AlecVanVlerken/BeanBot/src/beanbot/Config.h

#ifndef BEANBOT_CONFIG_H
#define BEANBOT_CONFIG_H

#include "Types.h"

namespace Config {

namespace Communication {
constexpr bool useWifi = true;
constexpr unsigned long baud = 115200;
constexpr unsigned long usbBaud = 9600;
constexpr int shieldPin = 25;
constexpr char commandStart[] = "CMDS/";
constexpr char commandEnd[] = "/CMDEND/";
constexpr char setupStart[] = "SETUPB/";
constexpr char setupEnd[] = "/SETUPE/";
}

// The startup defaults and the local/demo request were different in the sketch.
constexpr beanbot::Order initialOrder = {50, 50, 100};
constexpr beanbot::Order demoOrder = {100, 150, 200};
constexpr int reservoirCount = 3;

namespace Servo {
constexpr int carriageConnector = 12;
constexpr int gateConnector = 11;
constexpr int probeConnector = 9;
constexpr int lastChannel = 15; // PCA9685 channel = 15 - shield connector.
constexpr int frequencyHz = 50;
constexpr unsigned long oscillatorHz = 27000000;
constexpr int pulseMin = 80;
constexpr int pulseMax = 409;
constexpr int minimumAngle = 0;
constexpr int standardRange = 180;
constexpr int carriageForward = 0;
constexpr int carriageBack = 180;
constexpr int gateClosed = 145;
constexpr int gateOpen = 45; // Preserve the implementation, not the old "65" comment.
constexpr int probeRange = 270;
constexpr int probeTop = 270;
constexpr int firstProbeStep = 1;
constexpr int lastProbeStep = 120;
constexpr int probeStep = 1;
constexpr unsigned long travelDelayMs = 10000;
// Owner recalls 2.5 as deliberate hardware tuning; retain the original call.
// Its unit and relationship to modeled scan time remain unconfirmed.
constexpr double probeDelayUs = 2.5;
}

namespace Scale {
constexpr int dataPin = 3;
constexpr int clockPin = 2;
constexpr long calibrationFactor = -7050.0;
}

namespace ColorSensor {
constexpr int s0 = 45;
constexpr int s1 = 4;
constexpr int s2 = 53;
constexpr int s3 = 46;
constexpr int outputPin = 28;
constexpr int enablePin = 52;
constexpr unsigned long readingDelayMs = 100;

// Original active classifier: white first, then black, otherwise red.
constexpr int redMaxWhite = 170;
constexpr int greenMinBlack = 220;
}

namespace Conveyor {
constexpr int enablePin = 9;
constexpr int reversePin = 8;
constexpr unsigned long reverseDelayMs = 10000;
}

namespace Frame {
constexpr int stepPin = 12;
constexpr int directionPin = 13;
constexpr int enablePin = 11;
constexpr int smallSteps = 8;
constexpr int largeSteps = 17;
constexpr unsigned long pulseDelayMs = 100;
constexpr unsigned long settleDelayMs = 5000;
}

namespace DistanceSensor {
constexpr int triggerPin = 44;
constexpr int echoPin = 48;
constexpr unsigned int triggerLowUs = 2;
constexpr unsigned int triggerHighUs = 10;
constexpr long microsecondsPerCentimeter = 29;
}

namespace Inventory {
// Preserve the stated values without integer truncation.
constexpr double maximumHeight = 4.72;
constexpr double base = 18.29;
constexpr double angle = 17; // Degrees; converted at the calculation boundary.
constexpr double length = 12.98;
constexpr double rpm = 71.43;
constexpr double initialHeight = 10;
constexpr double radius = 2.4;
constexpr double whiteRedBeanWeight = 1.0 / 3.0;
constexpr double blackBeanWeight = 1.0 / 6.0;
constexpr double whiteRedBeanVolume = 0.75;
constexpr double blackBeanVolume = 0.50;
constexpr double timeIncrement = 2.5;
constexpr double pi = 3.1415;
}

namespace Display {
constexpr int rs = 21; // Owner says to retain the tested pin configuration.
constexpr int enablePin = 14;
constexpr int d4 = 19;
constexpr int d5 = 7;
constexpr int d6 = 6;
constexpr int d7 = 18;
constexpr int columns = 16;
constexpr int rows = 2;
constexpr int redPosition = 2;
constexpr int whitePosition = 3;
constexpr int blackPosition = 1;
}

constexpr unsigned long unloadDelayMs = 10000;

} // namespace Config

#endif
