AlecVanVlerken/BeanBot/src/beanbot/Types.h

#ifndef BEANBOT_TYPES_H
#define BEANBOT_TYPES_H

namespace beanbot {

enum class BeanColor { None, White, Black, Red };

struct Order {
  int whiteGrams;
  int blackGrams;
  int redGrams;
};

struct StockEntry {
  int weightGrams;
  int displayPosition;
};

struct Stock {
  StockEntry white;
  StockEntry black;
  StockEntry red;
};

struct CollectionProgress {
  long currentWeight;
  long previousWeight;
  int reservoirsVisited;
  BeanColor selectedColor;
};

struct ColorReading {
  int red;
  int green;
  int blue;
};

} // namespace beanbot

#endif
