AlecVanVlerken/BeanBot/(commit log)

2026-09-29 Import existing BeanBot Arduino project
2026-09-29 extract BeanBot sensors from workflow decisions
